VirToReal/VirToCut/OpenScadDokumentation/README.md

# DESCRIPTION

These are pictures of each printable part, named by the activated printpart-name of the "ConstructionTemplate.scad". 
In each scetch are added dimension of the most common dimensions which you can compare to the parameters given in 
the Construction-Template. If you find some bugs, please feel free to alter the also added ".svg"-files. 
I will merge them as soon as I checked them. 

## printwa
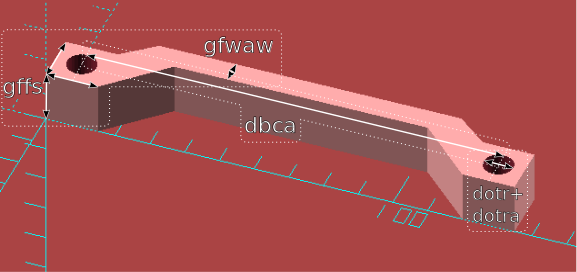
[picture p8: OpenScadDokumentation/printwa.png]
printwa


## printifc
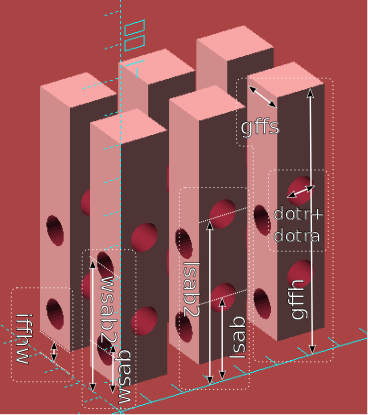
[picture p9: OpenScadDokumentation/printifc.png]
printifc


## printiff
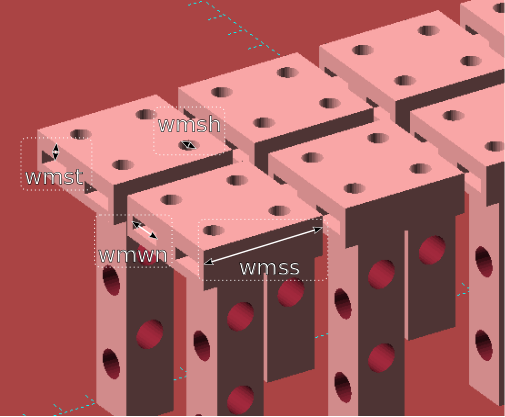
[picture p10: OpenScadDokumentation/printiff.png]
printiff


## printiffs
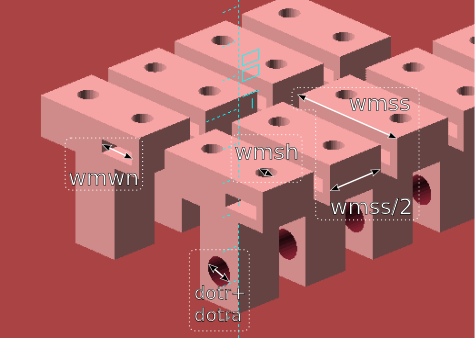
[picture p11: OpenScadDokumentation/printiffs.png]
printiffs


## printxacb Engine-Side Part #2
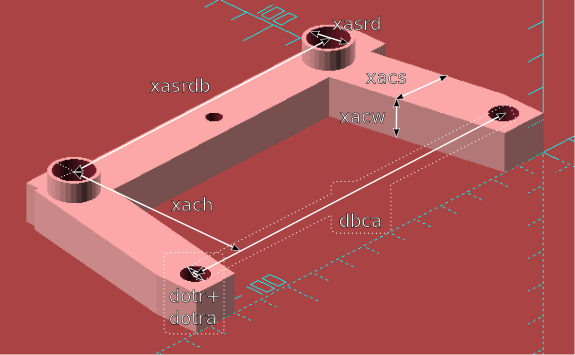
[picture p12: OpenScadDokumentation/printxacb_false_2.png]
printxacb

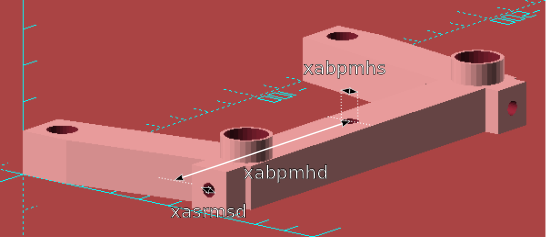
[picture p13: OpenScadDokumentation/printxacb_false_2_2.png]
printxacb


## printxacb Engine-Side Part #3
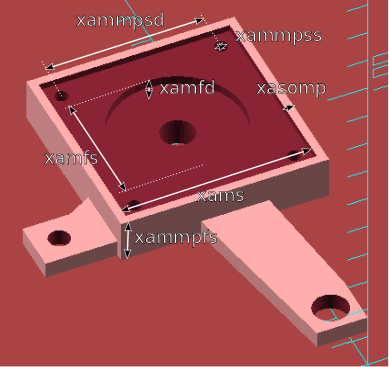
[picture p14: OpenScadDokumentation/printxacb_false_3.png]
printxacb


## printxacb Engine-Side Part #4
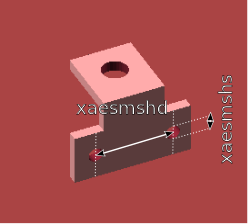
[picture p15: OpenScadDokumentation/printxacb_false_4.png]
printxacb


## printxacb Engine-Side Part #5
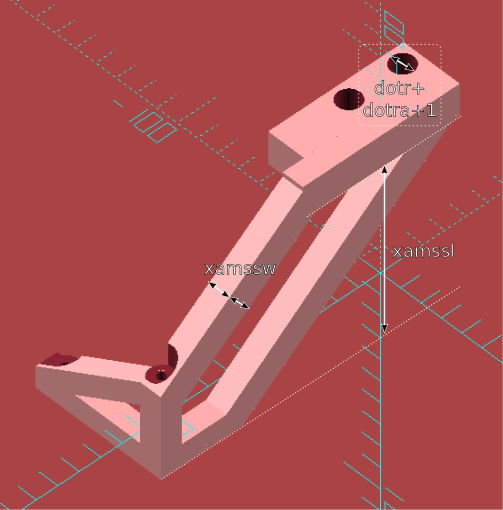
[picture p16: OpenScadDokumentation/printxacb_false_5.png]
printxacb


## printxacb Bearing-Side Part #2
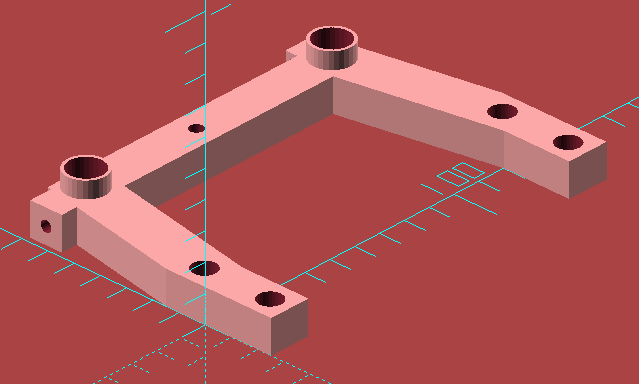
[picture p17: OpenScadDokumentation/printxacb_true_2.png]
printxacb


## printxacb Bearing-Side Part #3
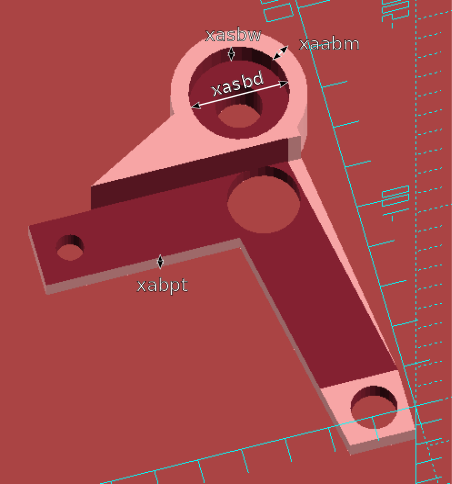
[picture p18: OpenScadDokumentation/printxacb_true_3.png]
printxacb


## printtrfebcn Part #1
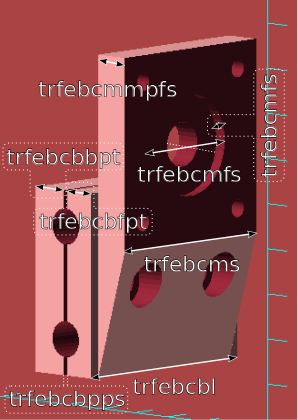
[picture p19: OpenScadDokumentation/printtrfebcn_1.png]

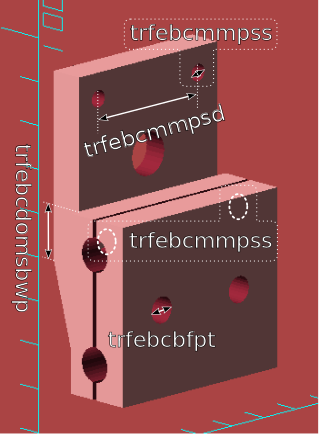
[picture p20: OpenScadDokumentation/printtrfebcn_1_2.png]


## printtrfebcn Part #2
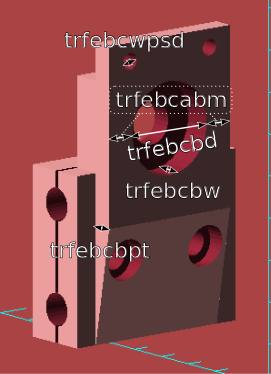
[picture p21: OpenScadDokumentation/printtrfebcn_2.png]


## printtrfebcn Part #3
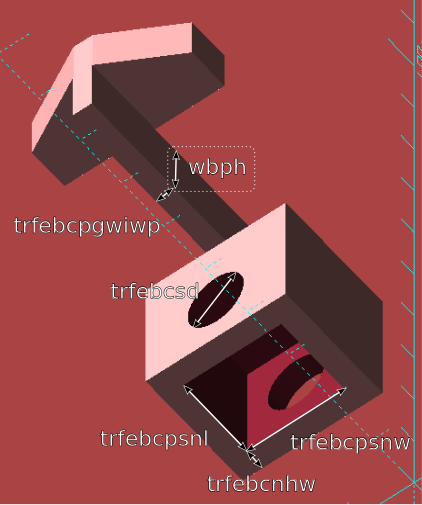
[picture p22: OpenScadDokumentation/printtrfebcn_3.png]

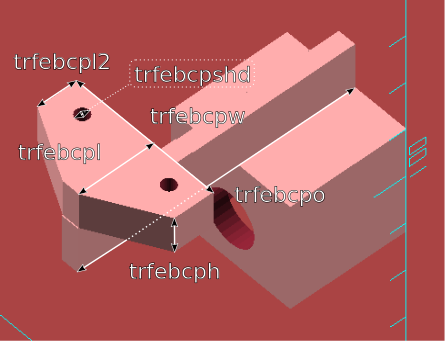
[picture p23: OpenScadDokumentation/printtrfebcn_3_2.png]


## printtrfebcn Part #4
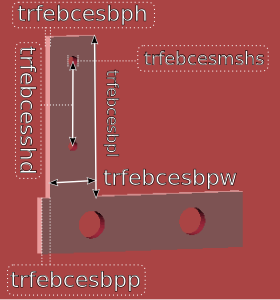
[picture p24: OpenScadDokumentation/printtrfebcn_4.png]


## printtc
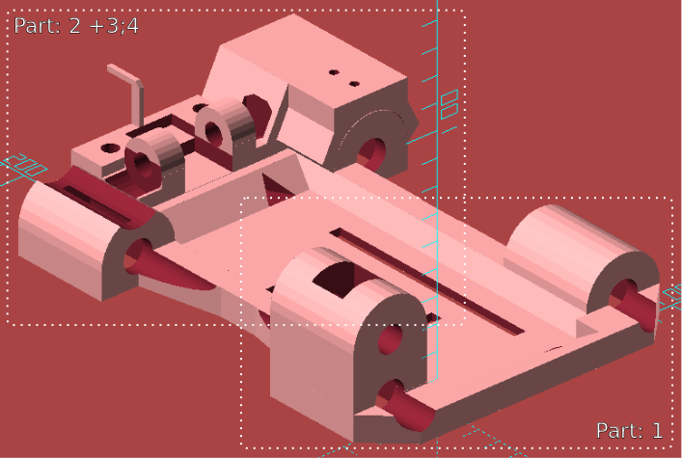
[picture p25: OpenScadDokumentation/printtc.png]
printtc


## printtc Part #1
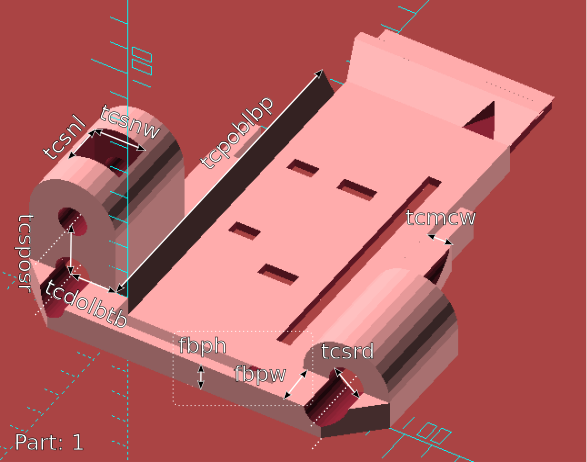
[picture p26: OpenScadDokumentation/printtc_1.png]
printtc

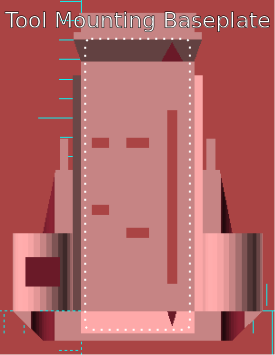
[picture p27: OpenScadDokumentation/printtc_1_0.png]
printtc

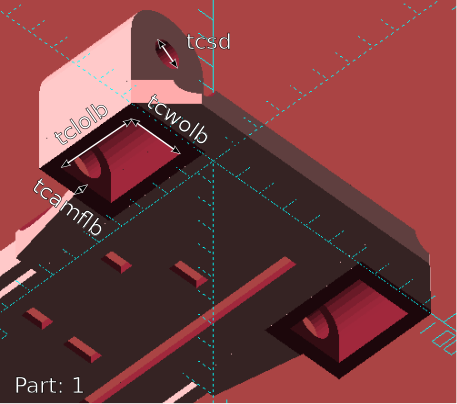
[picture p28: OpenScadDokumentation/printtc_1_1.png]
printtc

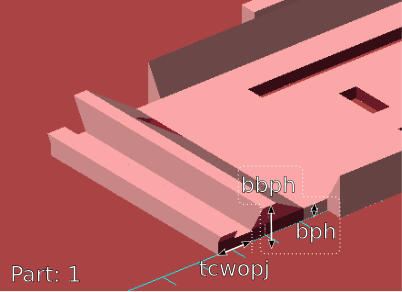
[picture p29: OpenScadDokumentation/printtc_1_2.png]
printtc


## printtc Part #2
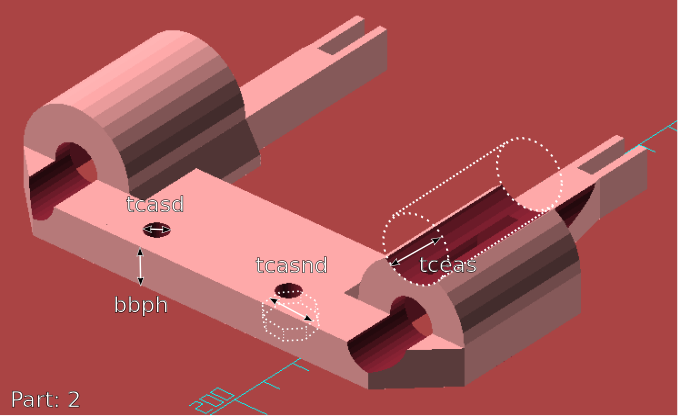
[picture p30: OpenScadDokumentation/printtc_2.png]
printtc

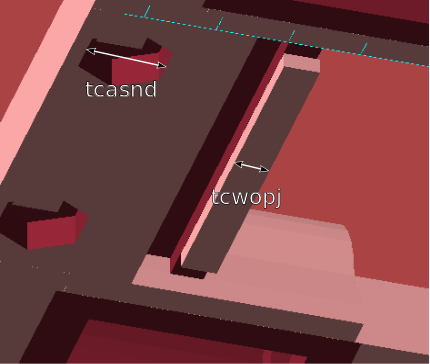
[picture p31: OpenScadDokumentation/printtc_2_1.png]
printtc


## printtc Part #3
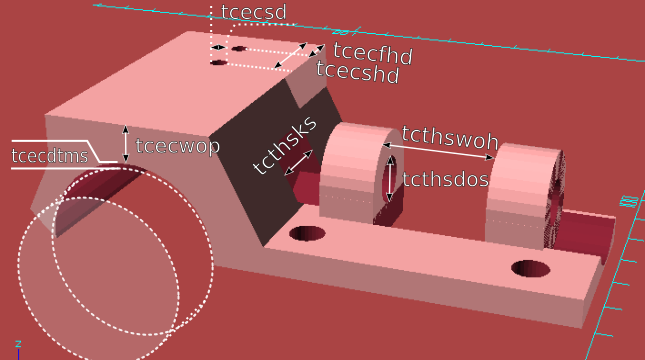
[picture p32: OpenScadDokumentation/printtc_3.png]
printtc


## printtc Part #4
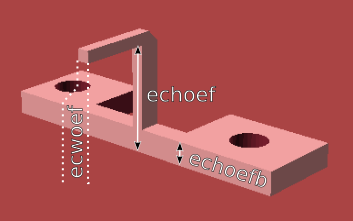
[picture p33: OpenScadDokumentation/printtc_4.png]
printtc


## printwcl Part #0
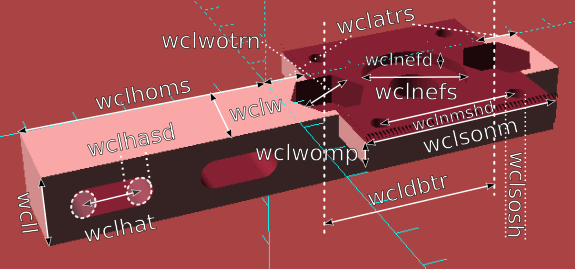
[picture p34: OpenScadDokumentation/printwcl_0.png]


## printwcl Part #1
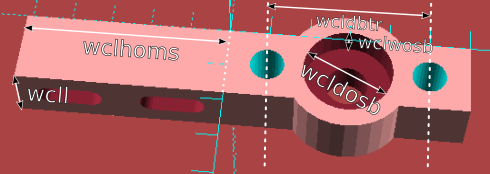
[picture p35: OpenScadDokumentation/printwcl_1.png]


## printwcl Part #2
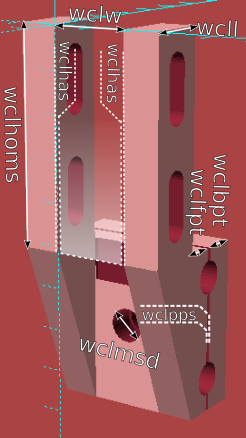
[picture p36: OpenScadDokumentation/printwcl_2.png]


## printwcl Part #3
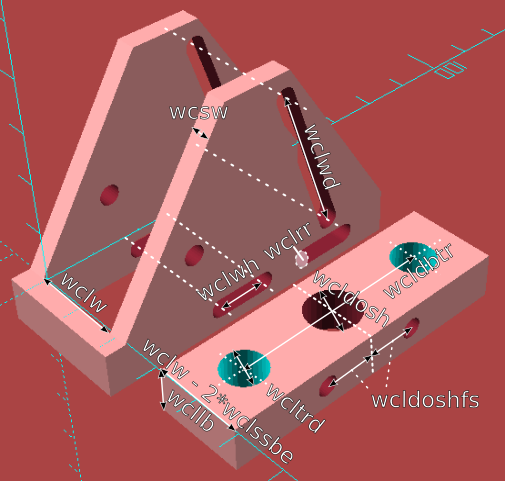
[picture p37: OpenScadDokumentation/printwcl_3.png]


## printwcl Part #4
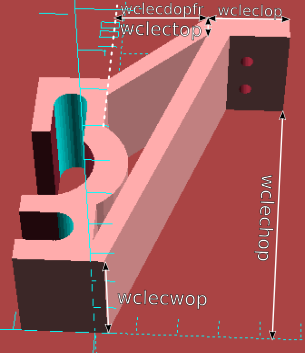
[picture p38: OpenScadDokumentation/printwcl_4.png]


## printwcl Part #5
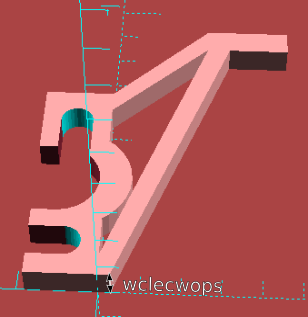
[picture p39: OpenScadDokumentation/printwcl_5.png]


## Whole Structure
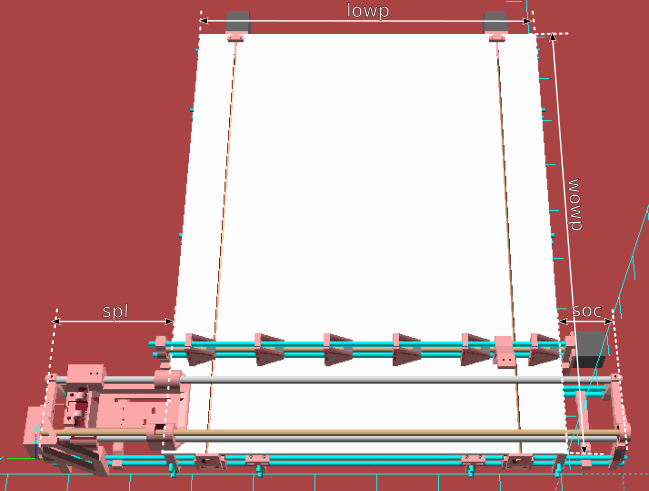
[picture p40: OpenScadDokumentation/total.png]
