VirToReal/VirToCut/Templates/Controlunit and Controlpaneel/Atx_Platinen_Bef-Lay-Kombiniert.png

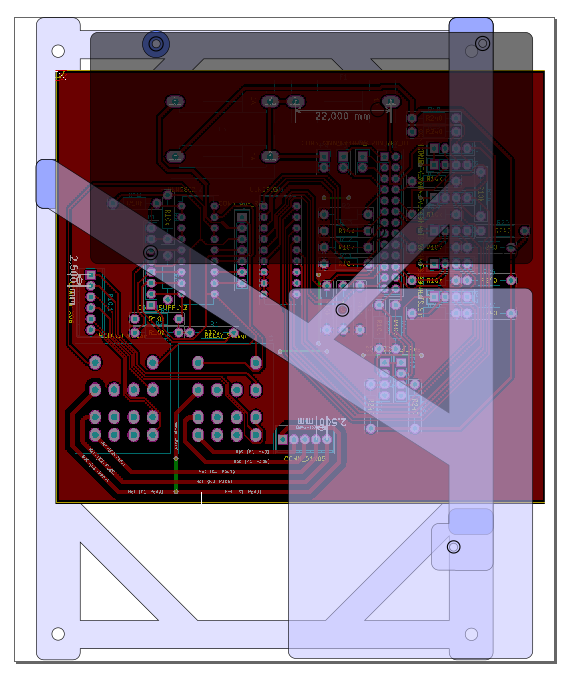
Templates/Controlunit and Controlpaneel/Atx_Platinen_Bef-Lay-Kombiniert.png
