VirToReal/VirToCut/Templates/Controlunit and Controlpaneel/ATX_Platinenhalter_Layer1.stl

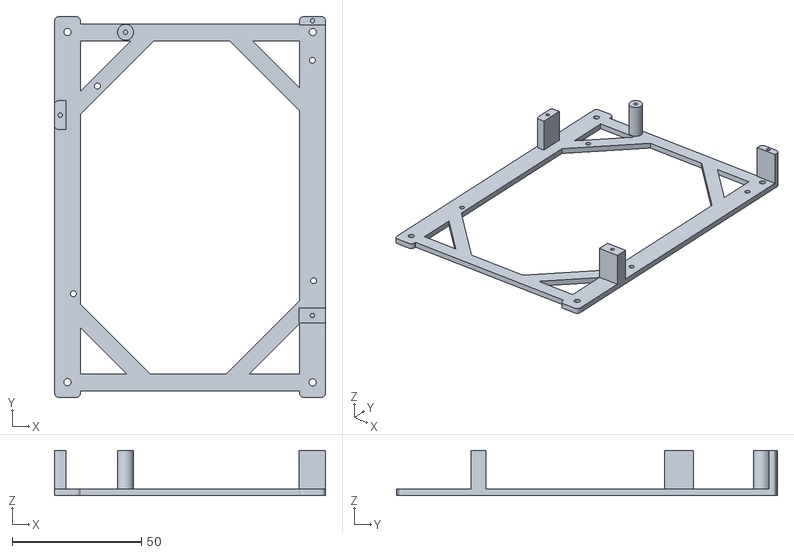
[picture p42: CAD file, 2016-12-17]
Templates/Controlunit and Controlpaneel/ATX_Platinenhalter_Layer1.stl
105.1 x 147.6 x 17.5
