VirToReal/VirToCut/Templates/Controlunit and Controlpaneel/STL Dateien james_III Skeleton ATX Gehäuse/3_railhandle.stl

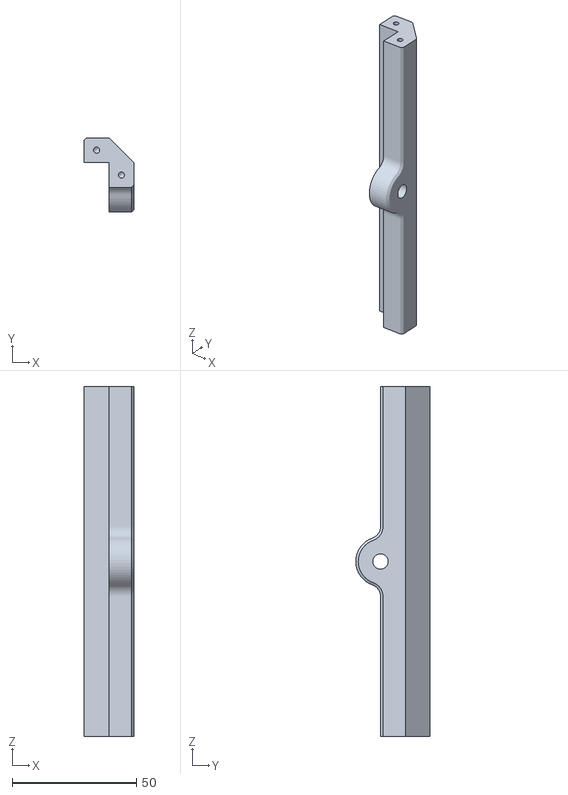
[picture p43: CAD file, 2016-12-17]
Templates/Controlunit and Controlpaneel/STL Dateien james_III Skeleton ATX Gehäuse/3_railhandle.stl
20.0 x 30.0 x 141.0
