VirToReal/VirToCut/Templates/JunctionBox Holder/Junction_box_mount.stl

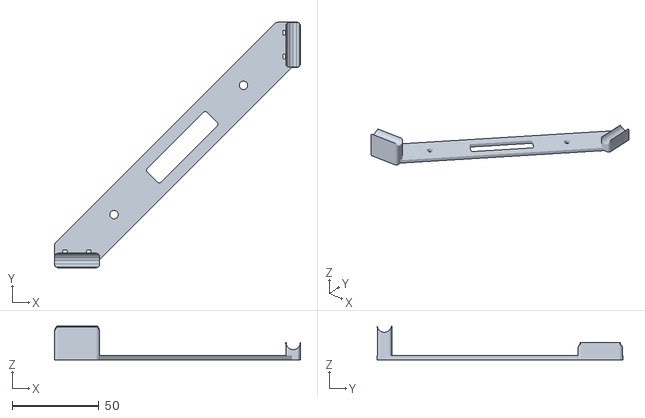
[picture p44: CAD file, 2016-12-17]
Templates/JunctionBox Holder/Junction_box_mount.stl
141.4 x 141.1 x 19.5
