VirToReal/VirToCut/Templates/Controlunit and Controlpaneel/STL Dateien james_III Skeleton ATX Gehäuse/5_handle.stl

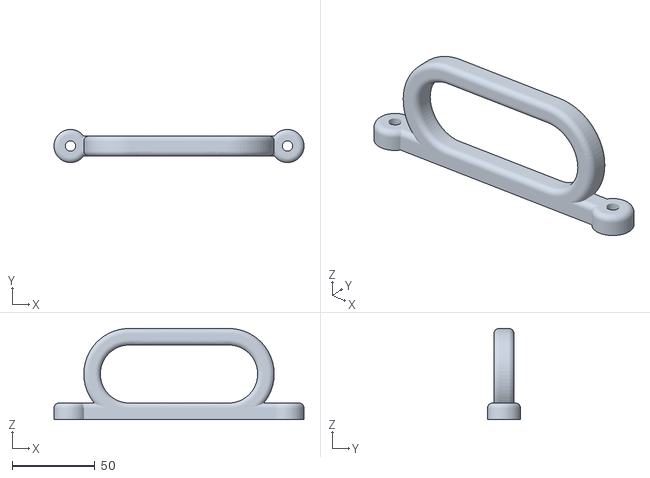
[picture p45: CAD file, 2016-12-17]
Templates/Controlunit and Controlpaneel/STL Dateien james_III Skeleton ATX Gehäuse/5_handle.stl
151.0 x 20.0 x 55.0
