VirToReal/VirToCut/Templates/JunctionBox Holder/Junction-Box_2.dxf

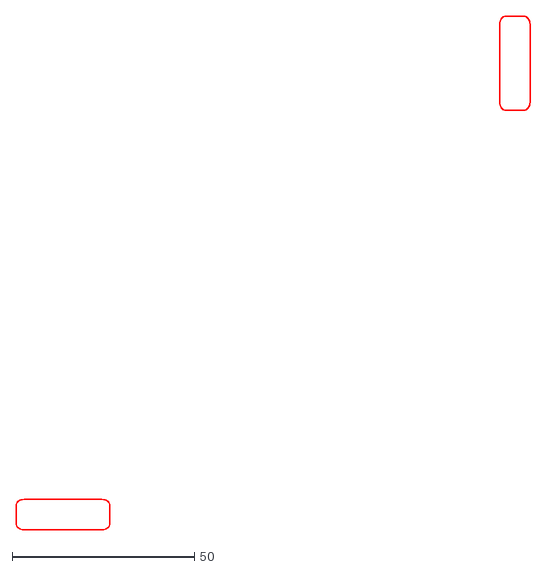
[picture p46: CAD file, 2016-12-17]
Templates/JunctionBox Holder/Junction-Box_2.dxf
141.2 x 141.0
