VirToReal/VirToCut/Templates/Controlunit and Controlpaneel/Anordnung V1_Layer2V2.dxf

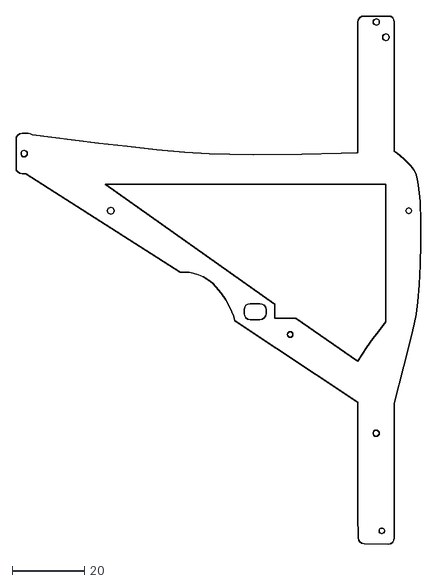
[picture p47: CAD file, 2016-12-17]
Templates/Controlunit and Controlpaneel/Anordnung V1_Layer2V2.dxf
112.4 x 146.5
