VirToReal/VirToCut/Templates/Controlunit and Controlpaneel/STL Dateien james_III Skeleton ATX Gehäuse/6_front_cutted.stl

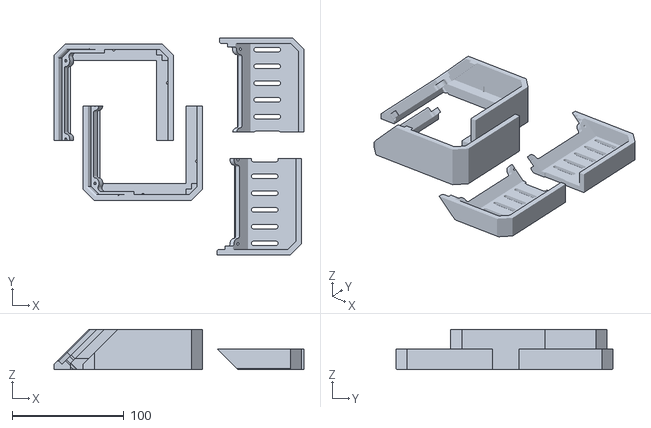
[picture p48: CAD file, 2016-12-17]
Templates/Controlunit and Controlpaneel/STL Dateien james_III Skeleton ATX Gehäuse/6_front_cutted.stl
224.1 x 194.6 x 36.3
