VirToReal/VirToCut/Templates/JunctionBox Holder/Junction-Box_1.dxf

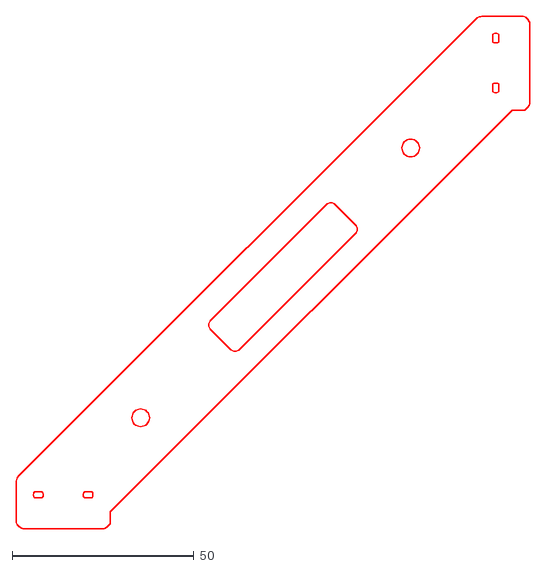
[picture p49: CAD file, 2016-12-17]
Templates/JunctionBox Holder/Junction-Box_1.dxf
141.4 x 141.1
