VirToReal/VirToCut/Templates/Controlunit and Controlpaneel/STL Dateien james_III Skeleton ATX Gehäuse/7_panel.stl

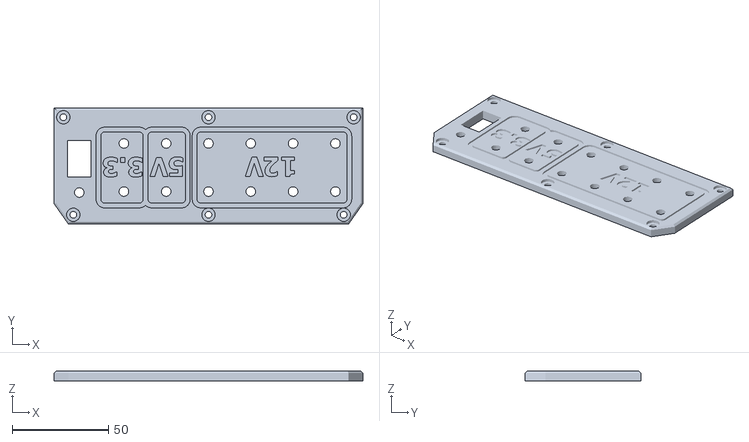
[picture p50: CAD file, 2016-12-17]
Templates/Controlunit and Controlpaneel/STL Dateien james_III Skeleton ATX Gehäuse/7_panel.stl
160.7 x 60.4 x 5.00
