VirToReal/VirToCut/Templates/Controlunit and Controlpaneel/Blende_Gehaeuse_ATX_Beschr.dxf

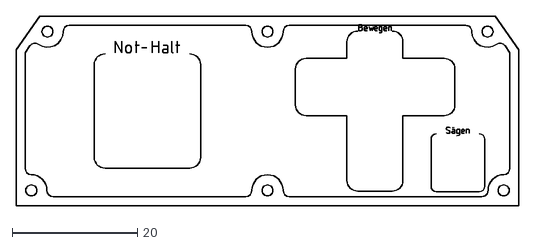
[picture p51: CAD file, 2016-12-17]
Templates/Controlunit and Controlpaneel/Blende_Gehaeuse_ATX_Beschr.dxf
80.3 x 30.2
