VirToReal/VirToCut/Templates/Controlunit and Controlpaneel/STL Dateien james_III Skeleton ATX Gehäuse/6_front.stl

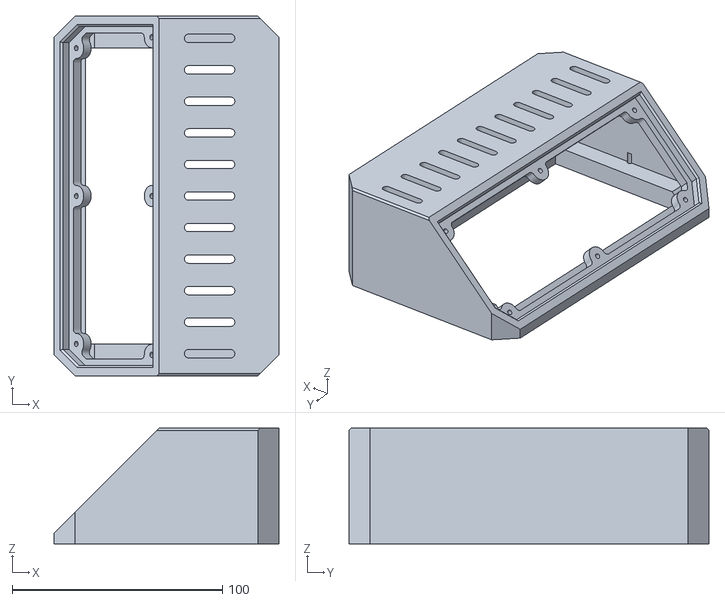
[picture p52: CAD file, 2016-12-17]
Templates/Controlunit and Controlpaneel/STL Dateien james_III Skeleton ATX Gehäuse/6_front.stl
107.0 x 171.0 x 55.0
