VirToReal/VirToCut/Templates/Controlunit and Controlpaneel/Anordnung V3.dxf

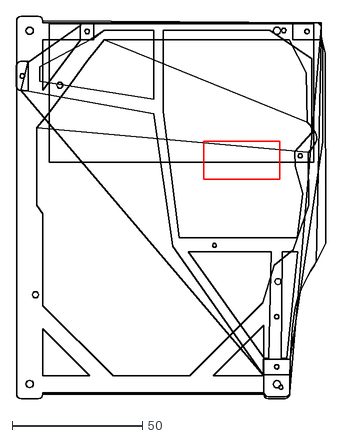
[picture p53: CAD file, 2016-12-17]
Templates/Controlunit and Controlpaneel/Anordnung V3.dxf
118.8 x 146.8
