VirToReal/VirToCut/Templates/Controlunit and Controlpaneel/Blende_Gehaeuse_ATX_Beschr_Ausschnitt.dxf

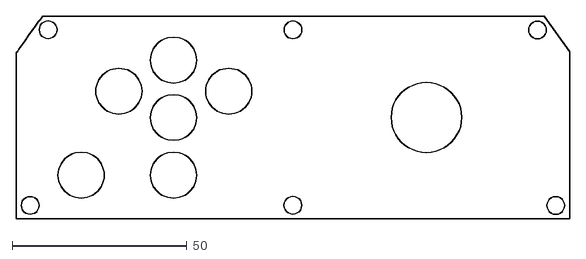
[picture p55: CAD file, 2016-12-17]
Templates/Controlunit and Controlpaneel/Blende_Gehaeuse_ATX_Beschr_Ausschnitt.dxf
158.4 x 58.0
