VirToReal/VirToCut/Templates/Controlunit and Controlpaneel/Anordnung V3_Layer12_bind_holes.dxf

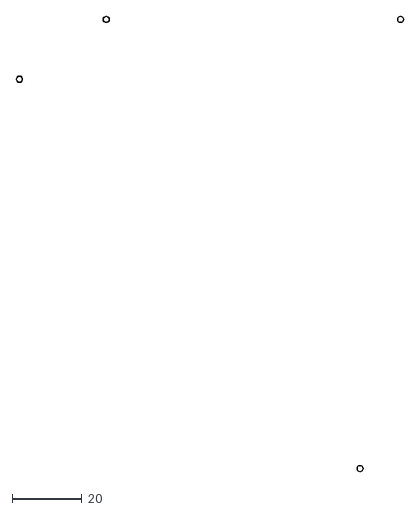
[picture p56: CAD file, 2016-12-17]
Templates/Controlunit and Controlpaneel/Anordnung V3_Layer12_bind_holes.dxf
111.0 x 130.5
