VirToReal/VirToCut/Templates/Controlunit and Controlpaneel/Blende_Gehaeuse_ATX_Beschr_Gravur.dxf

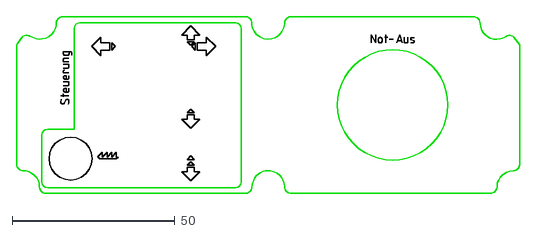
[picture p57: CAD file, 2016-12-17]
Templates/Controlunit and Controlpaneel/Blende_Gehaeuse_ATX_Beschr_Gravur.dxf
154.6 x 54.3
