VirToReal/VirToCut/Templates/Controlunit and Controlpaneel/STL Dateien james_III Skeleton ATX Gehäuse/emptypanel_dxfR12.dxf

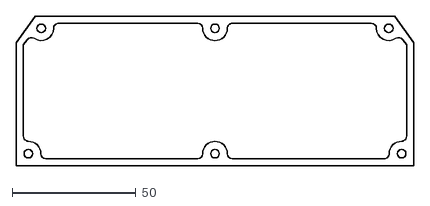
[picture p59: CAD file, 2016-12-17]
Templates/Controlunit and Controlpaneel/STL Dateien james_III Skeleton ATX Gehäuse/emptypanel_dxfR12.dxf
160.7 x 60.4
