VirToReal/VirToCut/Templates/Controlunit and Controlpaneel/Anordnung V3_Layer1.dxf

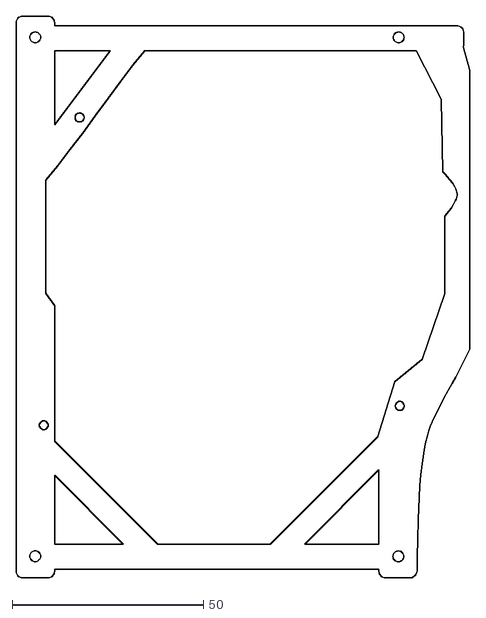
[picture p60: CAD file, 2016-12-17]
Templates/Controlunit and Controlpaneel/Anordnung V3_Layer1.dxf
118.7 x 146.8
