VirToReal/VirToCut/Templates/Controlunit and Controlpaneel/ATX_Platinenhalter_Layer2.stl

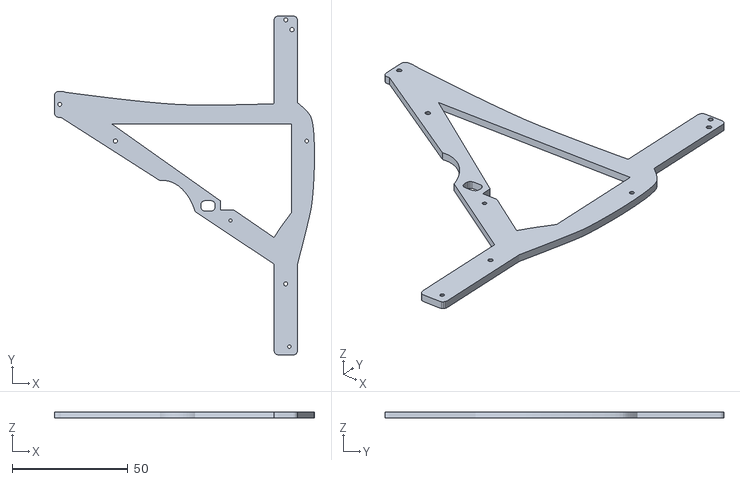
[picture p62: CAD file, 2016-12-17]
Templates/Controlunit and Controlpaneel/ATX_Platinenhalter_Layer2.stl
112.4 x 146.5 x 2.50
