VirToReal/VirToCut/Templates/Controlunit and Controlpaneel/Anordnung V3_Layer2.dxf

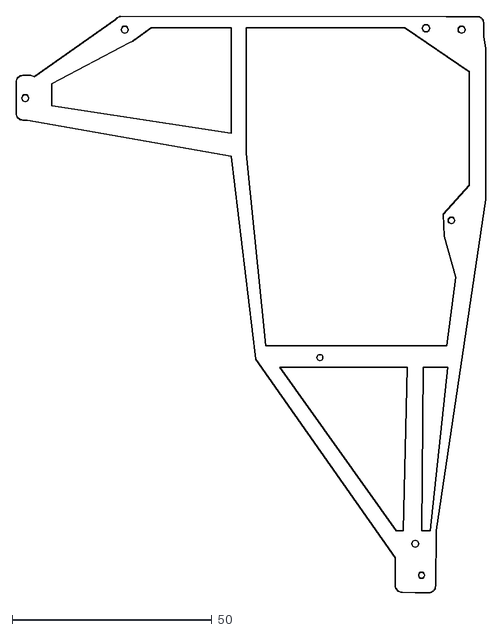
[picture p63: CAD file, 2016-12-17]
Templates/Controlunit and Controlpaneel/Anordnung V3_Layer2.dxf
117.6 x 144.3
