VirToReal/VirToCut/Templates/Controlunit and Controlpaneel/Zeichnung.dxf

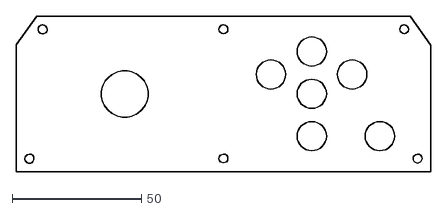
[picture p64: CAD file, 2016-12-17]
Templates/Controlunit and Controlpaneel/Zeichnung.dxf
160.4 x 60.1
