VirToReal/VirToCut/Templates/Controlunit and Controlpaneel/Zeichnung2.dxf

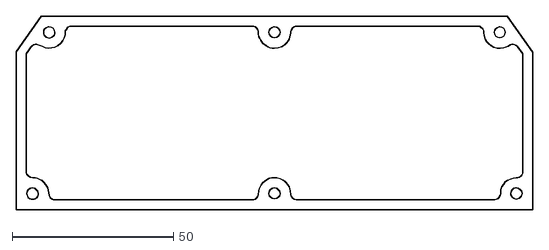
[picture p65: CAD file, 2016-12-17]
Templates/Controlunit and Controlpaneel/Zeichnung2.dxf
160.4 x 60.1
