VirToReal/VirToCut/Templates/Controlunit and Controlpaneel/Blende_Gehaeuse_ATX.stl

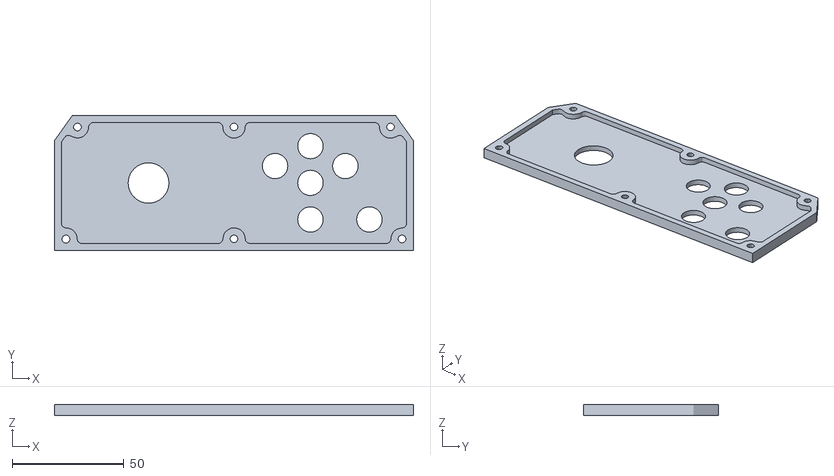
[picture p66: CAD file, 2016-12-17]
Templates/Controlunit and Controlpaneel/Blende_Gehaeuse_ATX.stl
160.4 x 60.1 x 5.00
