VirToReal/VirToCut/Templates/Controlunit and Controlpaneel/ATX_PlatinenhalterV3_Layer2.stl

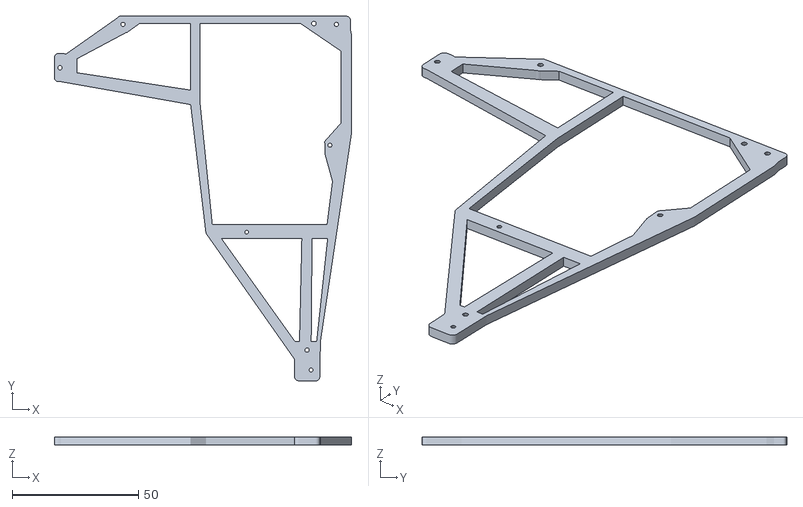
[picture p67: CAD file, 2016-12-17]
Templates/Controlunit and Controlpaneel/ATX_PlatinenhalterV3_Layer2.stl
117.6 x 144.3 x 3.00
