VirToReal/VirToCut/Templates/Controlunit and Controlpaneel/ATX_PlatinenhalterV3_Layer1.stl

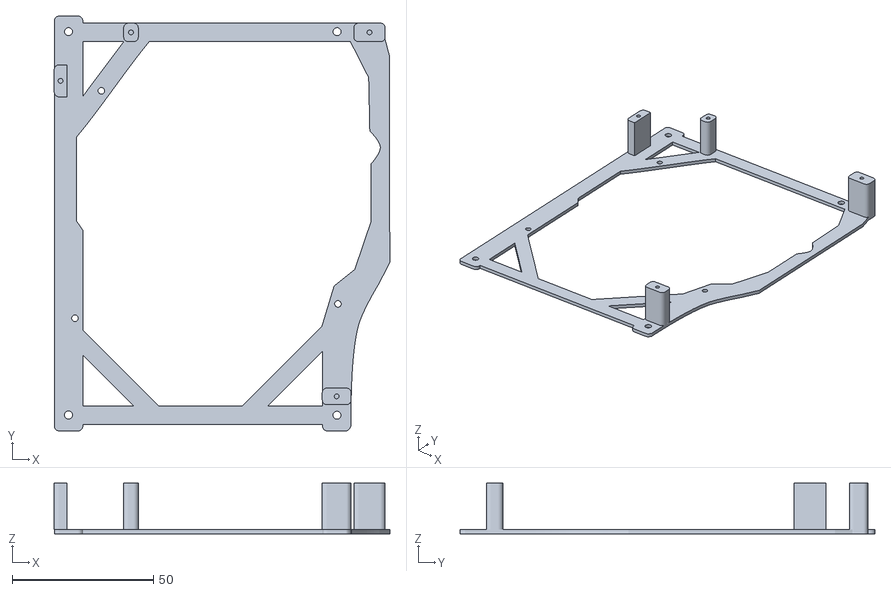
[picture p68: CAD file, 2016-12-17]
Templates/Controlunit and Controlpaneel/ATX_PlatinenhalterV3_Layer1.stl
118.7 x 146.8 x 18.0
