VirToReal/VirToCut/Templates/Controlunit and Controlpaneel/Anordnung V3_Layer12_bind.dxf

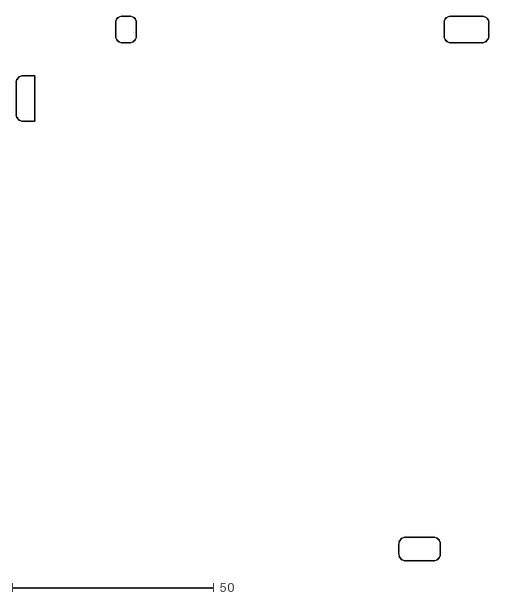
[picture p69: CAD file, 2016-12-17]
Templates/Controlunit and Controlpaneel/Anordnung V3_Layer12_bind.dxf
117.1 x 135.0
