VirToReal/VirToCut/Templates/Controlunit and Controlpaneel/Blende_Gehaeuse_ATX.scad

linear_extrude(height = 2.5, center = true, convexity = 10) import("Zeichnung.dxf"); 
translate ([0,0,2.5]) linear_extrude(height = 2.5, center = true, convexity = 10) import("Zeichnung2.dxf"); 
