VirToReal/VirToCut/(list of files, cad)

Other CAD files:
Templates/Controlunit and Controlpaneel/STL Dateien james_III Skeleton ATX Gehäuse/7.2_panel.stl
Templates/Controlunit and Controlpaneel/STL Dateien james_III Skeleton ATX Gehäuse/7.1_panel.stl
Templates/Controlunit and Controlpaneel/Anordnung V1_Layer1.dxf
Templates/Controlunit and Controlpaneel/Anordnung V1_Layer12_bind.dxf
Templates/Controlunit and Controlpaneel/Anordnung V1_Layer12_bind_holes.dxf
Templates/Controlunit and Controlpaneel/Anordnung V1_Layer2.dxf
Templates/Controlunit and Controlpaneel/Blende_Gehaeuse_ATX.dxf
Templates/Controlunit and Controlpaneel/STL Dateien james_III Skeleton ATX Gehäuse/panel_plain.ipt
