VirToReal/VirToCut/OpenScadDokumentation/printgff.png

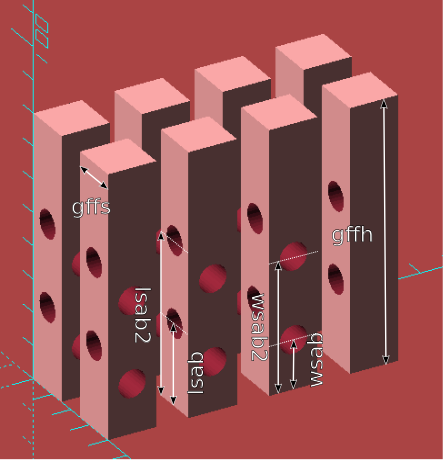
OpenScadDokumentation/printgff.png
