VirToReal/VirToCut/(list of files, drawings)

Other design files:
KiCad/RelaisAnbindung.dsn
