VirToReal/VirToCut/KiCad/RelaisAnbindung.kicad_pcb

## KiCad design KiCad/RelaisAnbindung.kicad_pcb (2016-12-17)

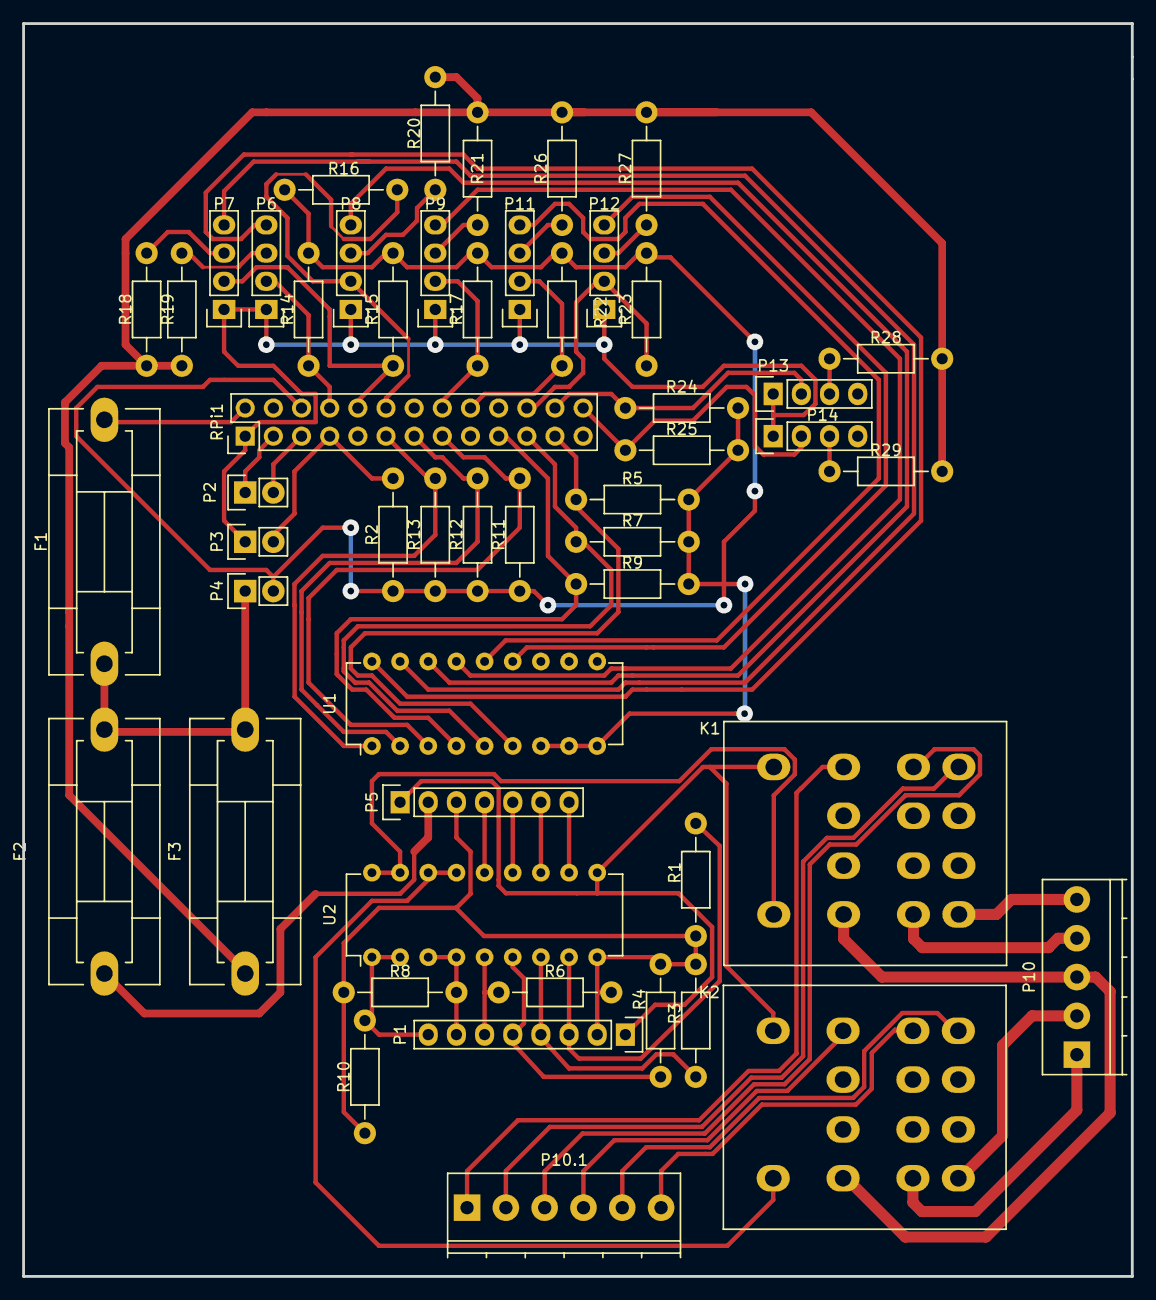
[picture p71: board RelaisAnbindung.kicad_pcb from above]

Board: 2 copper layers, 100.0 x 113.0 mm, 52 parts (0 on the bottom side), 62 nets.

Parts:
F1, F2, F3: 1A; Fuseholder5x20_horiz_SemiClosed_Casing10x25mm
K1: RELAY_Stbsgr; Relais_FIN94_Print-Socket
K2: RELAY_Hakrsae; Relais_FIN94_Print-Socket
P1: CONN_SUPPLY2; Pin_Header_Straight_1x08
P2: CONN_I^2C; Pin_Header_Straight_1x02
P3: CONN_Not-Aus; Pin_Header_Straight_1x02
P4: CONN_SUPPLY; Pin_Header_Straight_1x02
P5: CONN_Aux_Res; Pin_Header_Straight_1x07
P6: CONN_TV_Vr; Pin_Header_Straight_1x04
P7: CONN_TV_Zk; Pin_Header_Straight_1x04
P8: CONN_TV_GZk; Pin_Header_Straight_1x04
P9: CONN_TS_Vr; Pin_Header_Straight_1x04
P10: CONN_01X05; TerminalBlock_Pheonix_PT-3.5mm_5pol
P10.1: CONN_01X06; TerminalBlock_Pheonix_PT-3.5mm_6pol
P11: CONN_TS_Zk; Pin_Header_Straight_1x04
P12: CONN_TS_Snt; Pin_Header_Straight_1x04
P13, P14: CONN_T_Res; Pin_Header_Straight_1x04
R1, R2, R3, R4, R5, R6, R7, R8, R9, R10, R11, R12, R13, R14, R15, R16, R17, R22, R23, R24, R25: R10k; Resistor_Horizontal_RM10mm
R18, R19, R20, R21, R26, R27, R28, R29: R340; Resistor_Horizontal_RM10mm
RPi1: RASPBERRY_IO; Pin_Header_Straight_2x13
U1, U2: ULN2803; DIP-18_W7.62mm

Connections:
unnamed: F1.1, F2.2, F3.2, P4.1
unnamed: F1.2, RPi1.2
unnamed: F2.1, P5.2
unnamed: F3.1, R18.2, R19.2, R20.2, R21.2, R26.2, R27.2, R28.2, R29.2
unnamed: K1.1, P10.5
unnamed: K1.4, P10.1.2
unnamed: K1.5, P10.4
unnamed: K1.8, P10.1.3
unnamed: K1.9, K2.9, P10.3
unnamed: K1.12, P10.1.1
unnamed: K1.13, U2.17, U2.18
unnamed: K1.14, K2.14, P1.1, P5.1, U2.10
unnamed: K2.1, P10.2
unnamed: K2.4, P10.1.5
unnamed: K2.5, P10.1
unnamed: K2.8, P10.1.6
unnamed: K2.12, P10.1.4
unnamed: K2.13, U2.15, U2.16
unnamed: P1.2, P5.3, R1.2, R3.2, R4.2, R6.2, R8.2, R10.2, U2.9
unnamed: P1.3, R1.1, U2.8
unnamed: P1.4, R3.1, U2.7
unnamed: P1.5, R4.1, U2.6
unnamed: P1.6, R6.1, U2.5
unnamed: P1.7, R8.1, U2.3, U2.4
unnamed: P1.8, R10.1, U2.1, U2.2
unnamed: P2.1, RPi1.3
unnamed: P2.2, RPi1.5
unnamed: P3.2, R2.2, RPi1.7
unnamed: P4.2, R2.1, R5.1, R7.1, R9.1, R11.1, R12.1, R13.1, R14.1, R15.1, R16.1, R17.1, R22.1, R23.1, R24.1, R25.1, RPi1.6, U1.7, U1.8, U1.9
unnamed: P5.4, U2.14
unnamed: P5.5, U2.13
unnamed: P5.6, U2.12
unnamed: P5.7, U2.11
unnamed: P6.2, R14.2, RPi1.8
unnamed: P6.3, R18.1
unnamed: P6.4, U1.18
unnamed: P7.2, R15.2, RPi1.10
unnamed: P7.3, R19.1
unnamed: P7.4, U1.17
unnamed: P8.2, R16.2, RPi1.12
unnamed: P8.3, R20.1
unnamed: P8.4, U1.16
unnamed: P9.2, R17.2, RPi1.16
unnamed: P9.3, R21.1
unnamed: P9.4, U1.15
unnamed: P3.1, P6.1, P7.1, P8.1, P9.1, P11.1, P12.1, P13.1, P14.1, RPi1.1
unnamed: P11.2, R22.2, RPi1.18
unnamed: P11.3, R26.1
unnamed: P11.4, U1.14
unnamed: P12.2, R23.2, RPi1.22
unnamed: P12.3, R27.1
unnamed: P12.4, U1.13
unnamed: P13.2, R24.2, RPi1.24
unnamed: P13.3, R28.1
unnamed: P14.2, R25.2, RPi1.26
unnamed: P14.3, R29.1
unnamed: R5.2, RPi1.23, U1.6
unnamed: R7.2, RPi1.21, U1.5
unnamed: R9.2, RPi1.19, U1.4
unnamed: R11.2, RPi1.15, U1.3
unnamed: R12.2, RPi1.13, U1.2
unnamed: R13.2, RPi1.11, U1.1
