VirToReal/VirToCut/(commit log)

2016-11-20 Add files via upload
    early release of the Plate-Saw-Machine, still work to do
    [ConstructingTemplate.scad]
2016-11-20 Update ConstructingTemplate.scad
    whoops
    [ConstructingTemplate.scad]
2016-12-02 Add files via upload
    Tools / searching for G28 Command for calibrating absolute Y-Axis position (not tested yet)
    Dialogs / added 'distance of blade to left stop' to settings/parameters
    CommandsStack / fixed positioning information of feeder, added more safety functions etc.
    ControllGUI_9.glade / added absolute Y-Axis position and an expander under Settings/G-Codes with placeholder informations
    ControllGUI / several changes caused from the alterings above
    GPIO / new effect, not tested yet
    [CommandsStack.py, ControllGUI.py, Dialogs.py, GPIO.py, Tools.py]
2016-12-09 Add files via upload
    Several bug-fixes, improved manual movement and tested behavior on running machine
    [Tools.py]
2016-12-11 Add files via upload
    Fixed wrong interpretation of movement coordinates
    [SerialCommunication.py, Tools.py]
2016-12-11 Add files via upload
    corrected "vorschub" interpretation, but still not final
    [CommandsStack.py, Tools.py]
2016-12-17 Correct interpreting of cutting direction
    implemented correct cutting direction interpreting by searching through the "Schneiden" working-step for the <max_cut> placeholder.
    [CommandsStack.py, Tools.py]
2016-12-21 safety cut distance
    added safety cut distance to max_cut variable to prevent blade collision at feeding
    [CommandsStack.py]
2016-12-25 Added saw movement controll
    controlling if there is enough space for the saw to move via hardware-buttons
2016-12-27 added Forcing max. Cuttingdistance
    this Togglebutton in the Status-Tab in the sidemenu will allow the user to force the temporary position of the saw declared to be the max. position. So the user don't need to completely extend the saw to move the materialfeeder.
2017-01-07 Added Button-Press-Time operation
    Added minimal Presstime for each hardware-button
    Added long presstime for advanced operations
    (not tested yet)
2017-03-03 Fixed bad Hardware-Button behavior, PowerSupply management
    Added Queue for HardwareButtons because GTK dont like called functions in threads, which would be called via interrupt on the GPIO edge detection.
    Added automatic PowerSupply Power ON / OFF
    - not tested yet ;-) -
    [CommandsStack.py, ControllGUI.py, GPIO.py]
2017-03-05 Fixed behavieur of PS and Saw-Hardwarebutton
    - now the PowerSupply correctly turns on/off
    - Saw-Hardwarebutton now works and supplys the Pusher-Override-Mode
    [CommandsStack.py, ControllGUI.py, SerialCommunication.py]
2017-03-22 Add files via upload
    Added Picture-Description of each printable Part
2017-03-22 fixed bad saw-direction support
    Software should now consider the direction of the saw-blade at its programmed G-Code
    [CommandsStack.py, ControllGUI.py, Dialogs.py, SerialCommunication.py, Tools.py]
2021-11-10 Update README.md
    https://forum.kicad.info/t/warning-avoid-all-links-to-kicad-pcb-org-use-kicad-org/31521
